DRTech98/RGB-Initials-Sign/DR_SIGN_REDO__Assembly.pdf

A

A

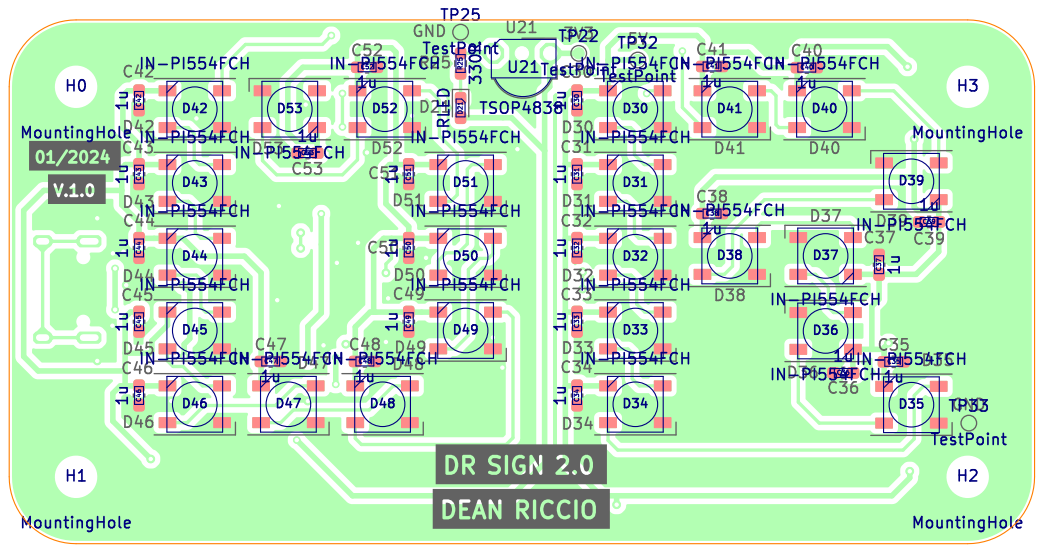
[picture p1: page 1]

Id: 1/1 Title: DR SIGN REDO

R20 C25 | C27 | C13 Y20 C22 R31 Q30 1 | 2 | 3 | 4 | 5 1 | 2 | 3 | 4 | 5 ABCD | ABCD Date: 2024-01-03 KiCad | E.D.A. | kicad | (7.0.0) Size: USLetter | Rev: 0.0

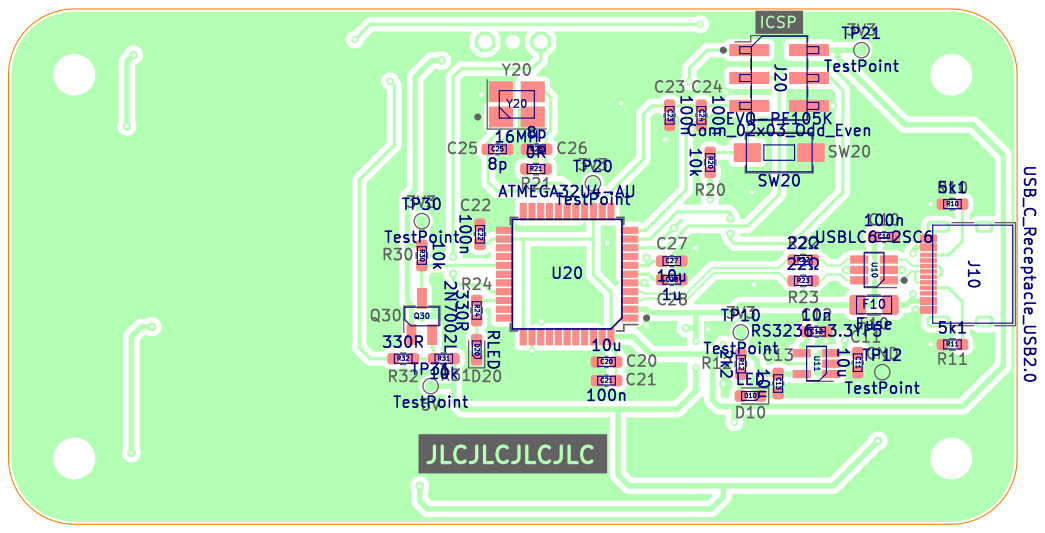
[picture p2: page 2]

Id: 1/1 Title: DR SIGN REDO
