DRTech98/RGB-Initials-Sign/DR_SIGN_REDO.pdf

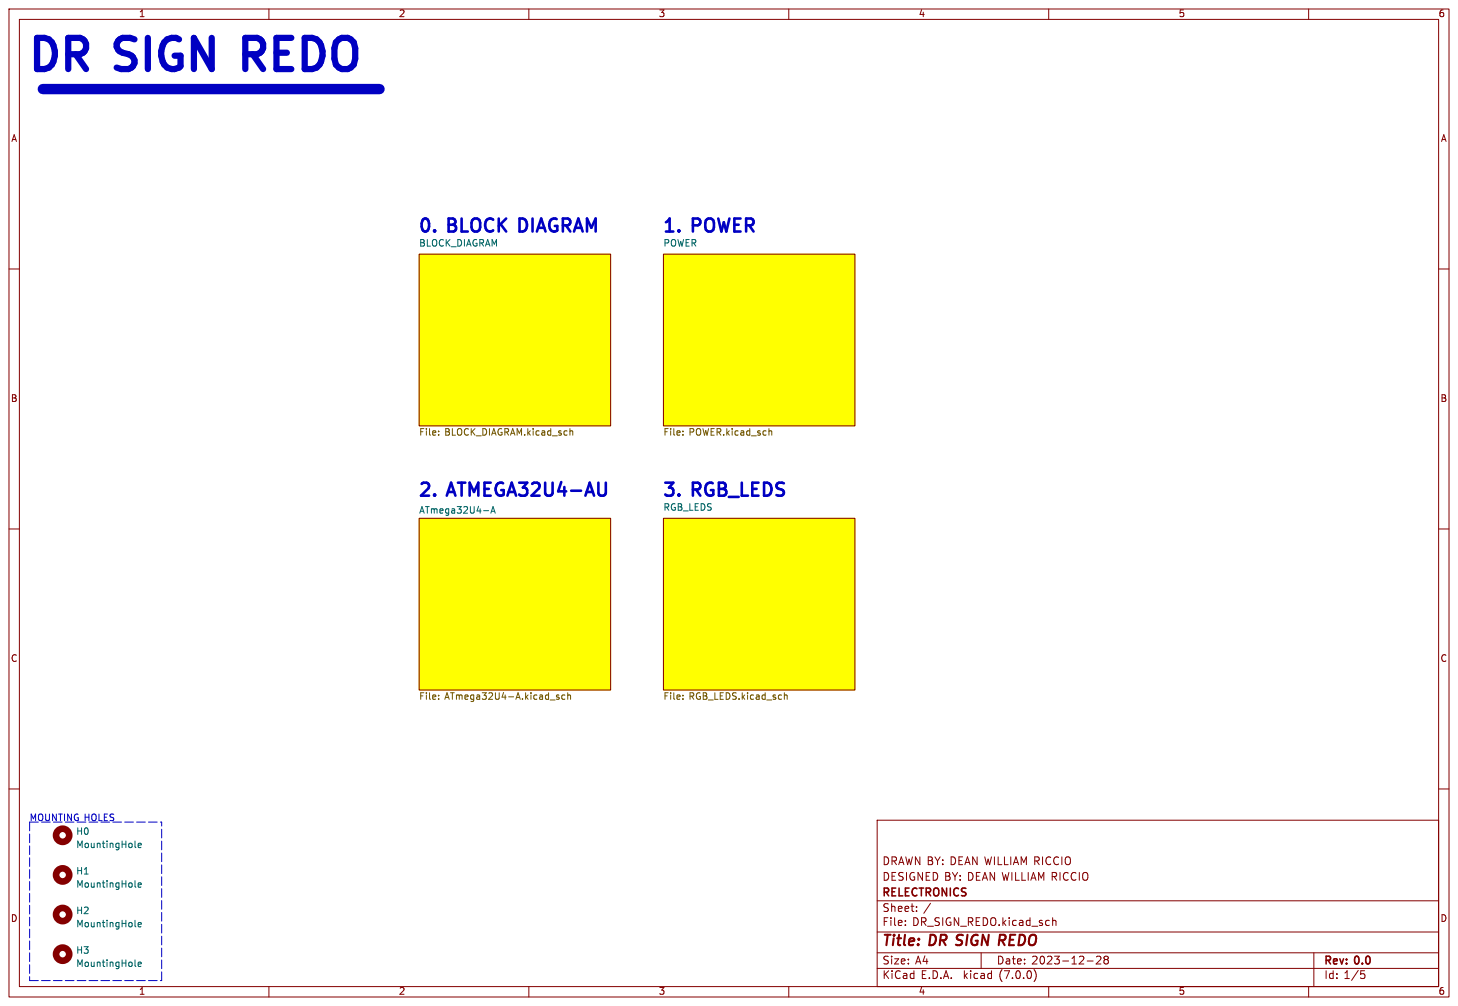
[picture p3: page 1]

File: ATmega32U4-A.kicad_sch H3 MountingHole H2 MountingHole H1 MountingHole H0 MountingHole

Id: 1/5 Title: DR SIGN REDO

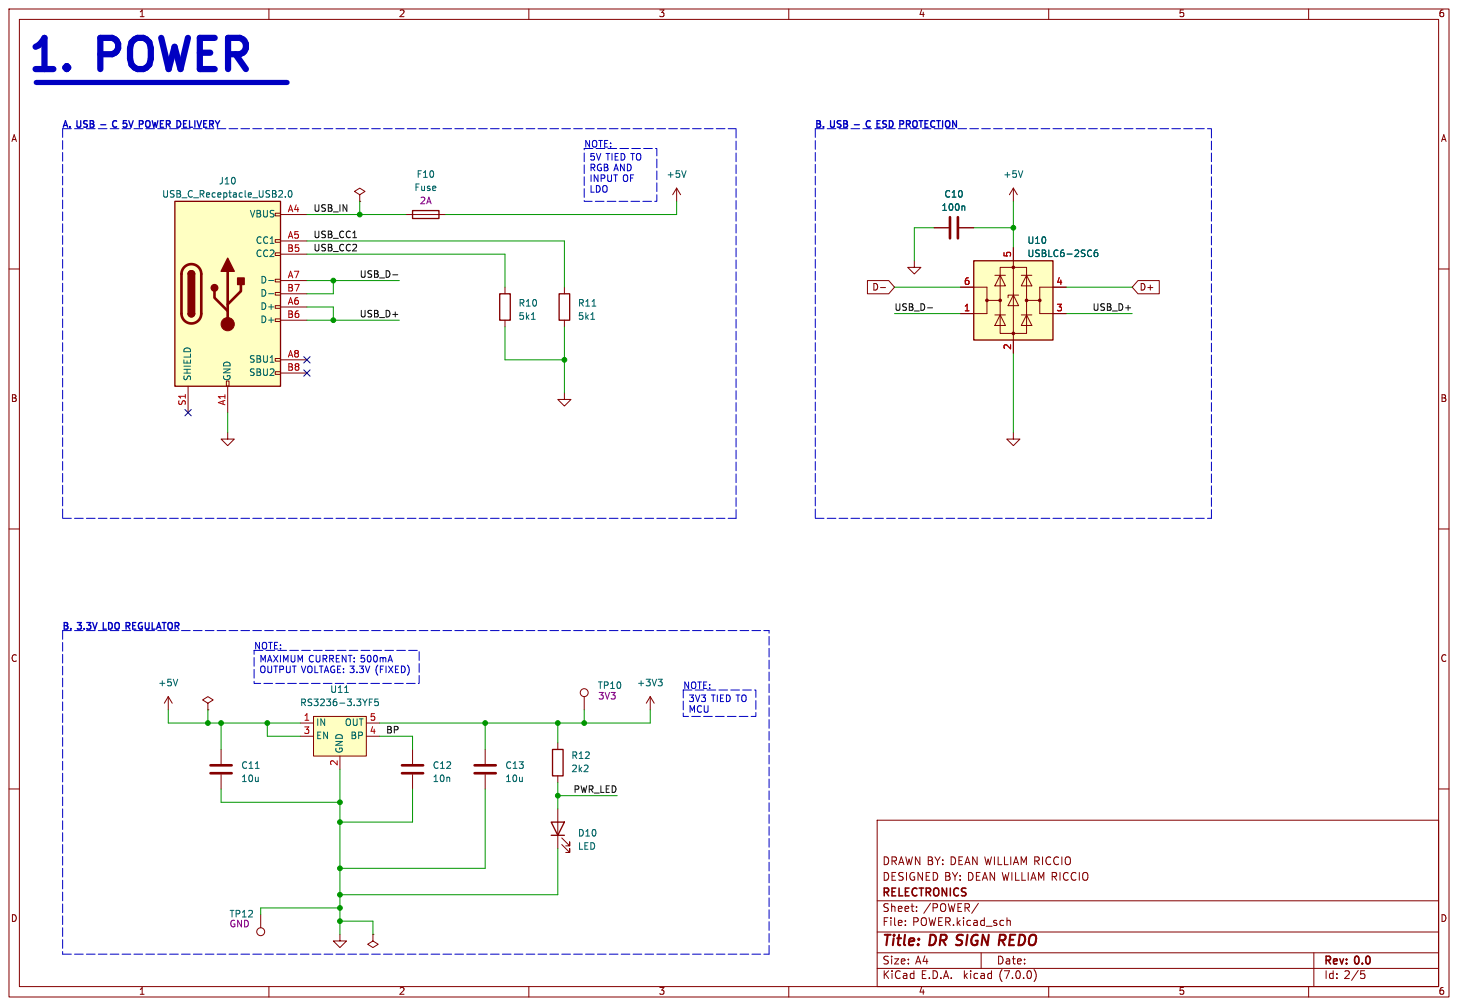
[picture p4: page 2]

A. USB - C 5V POWER DELIVERY B. 3.3V LDO REGULATOR

2 EN 3 BP 4 OUT 5 U11 RS3236-3.3YF5 TP12 GND

Id: 2/5 Title: DR SIGN REDO

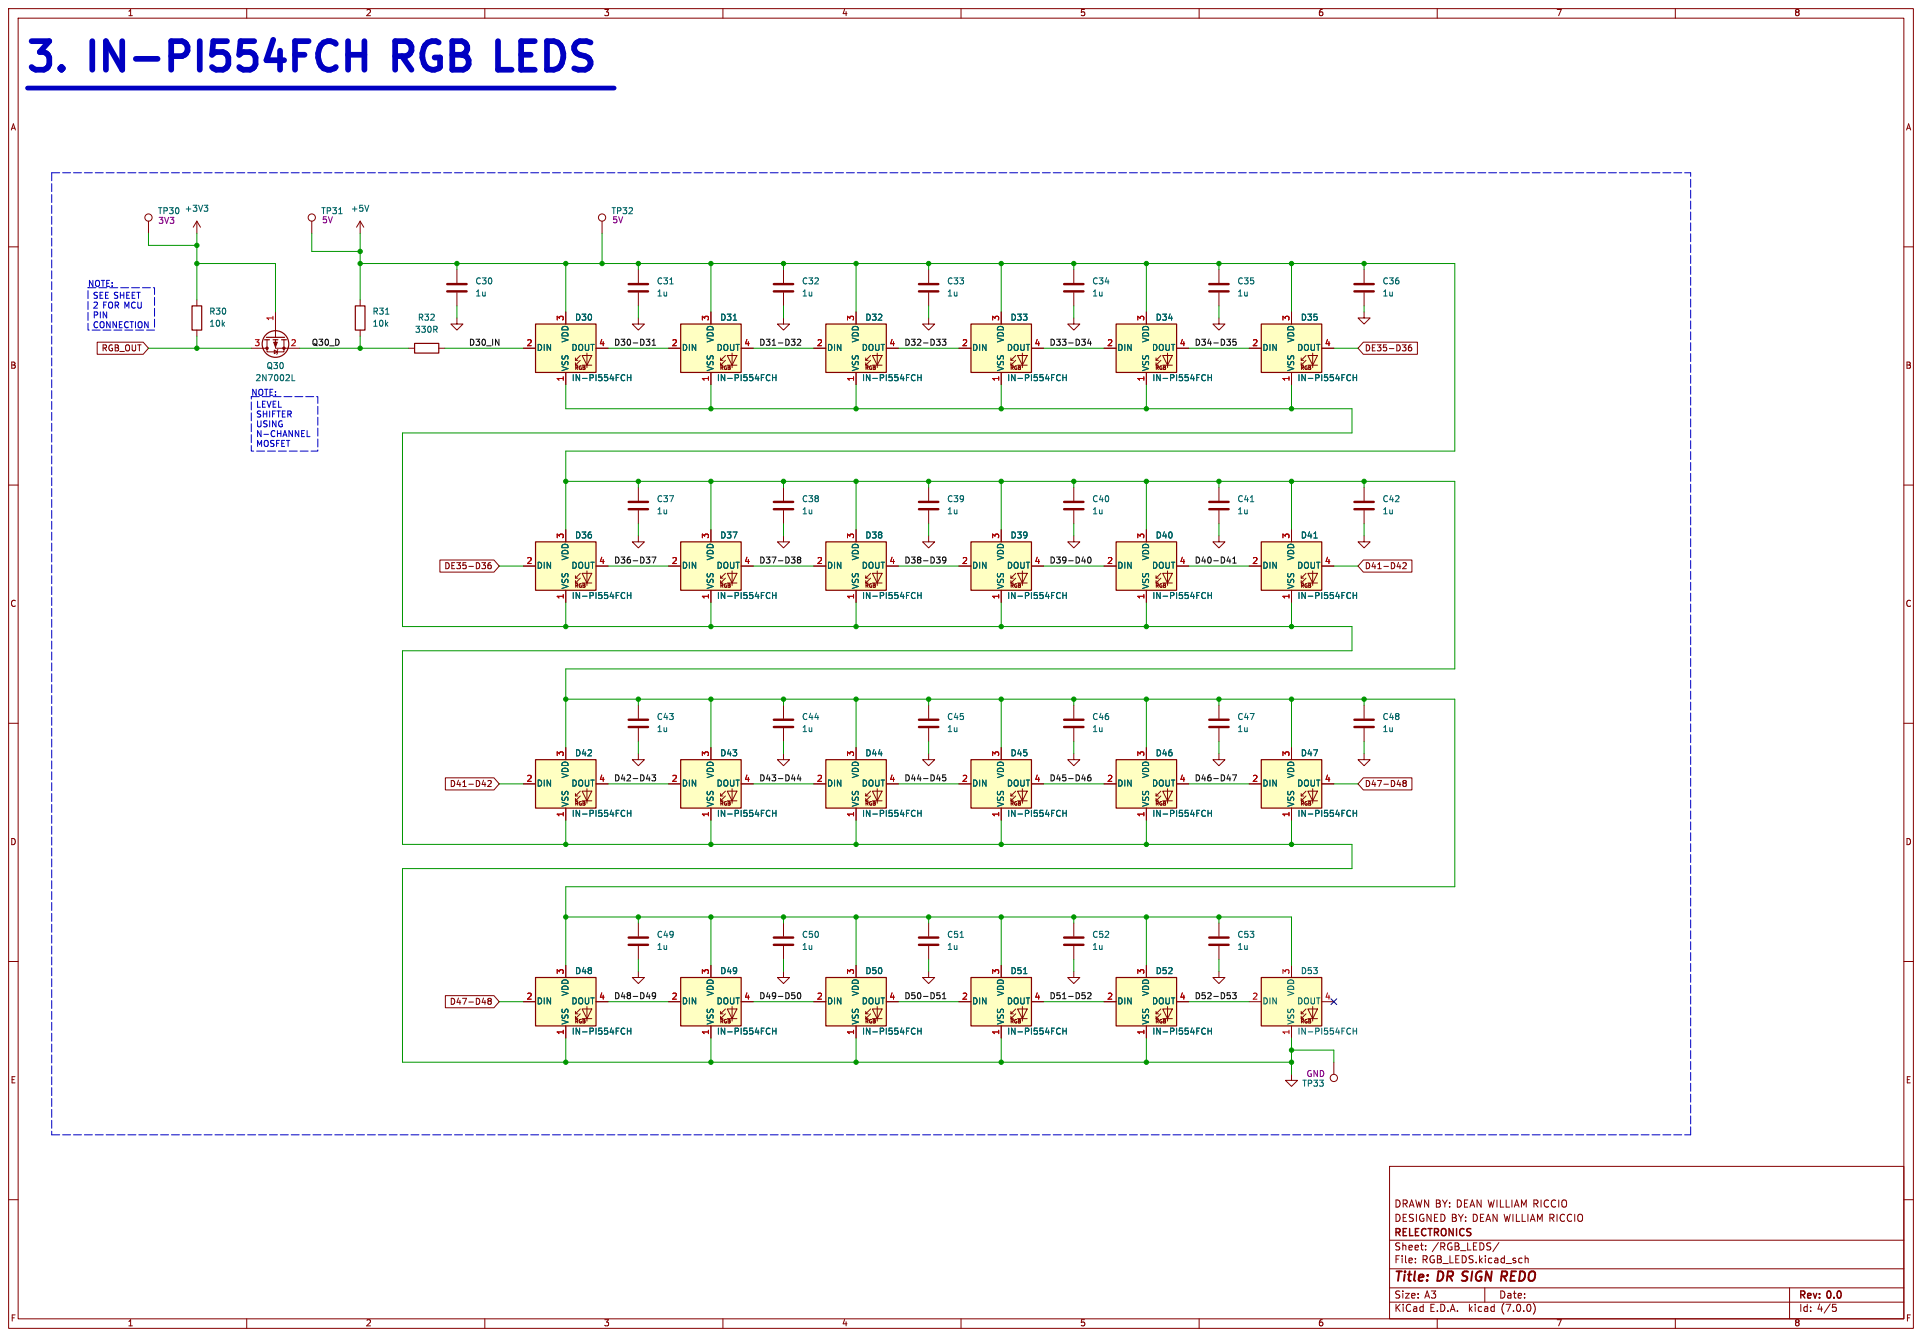
[picture p5: page 3]

N-CHANNEL MOSFET SEE SHEET
2 FOR MCU
PIN
CONNECTION

Id: 4/5 Title: DR SIGN REDO

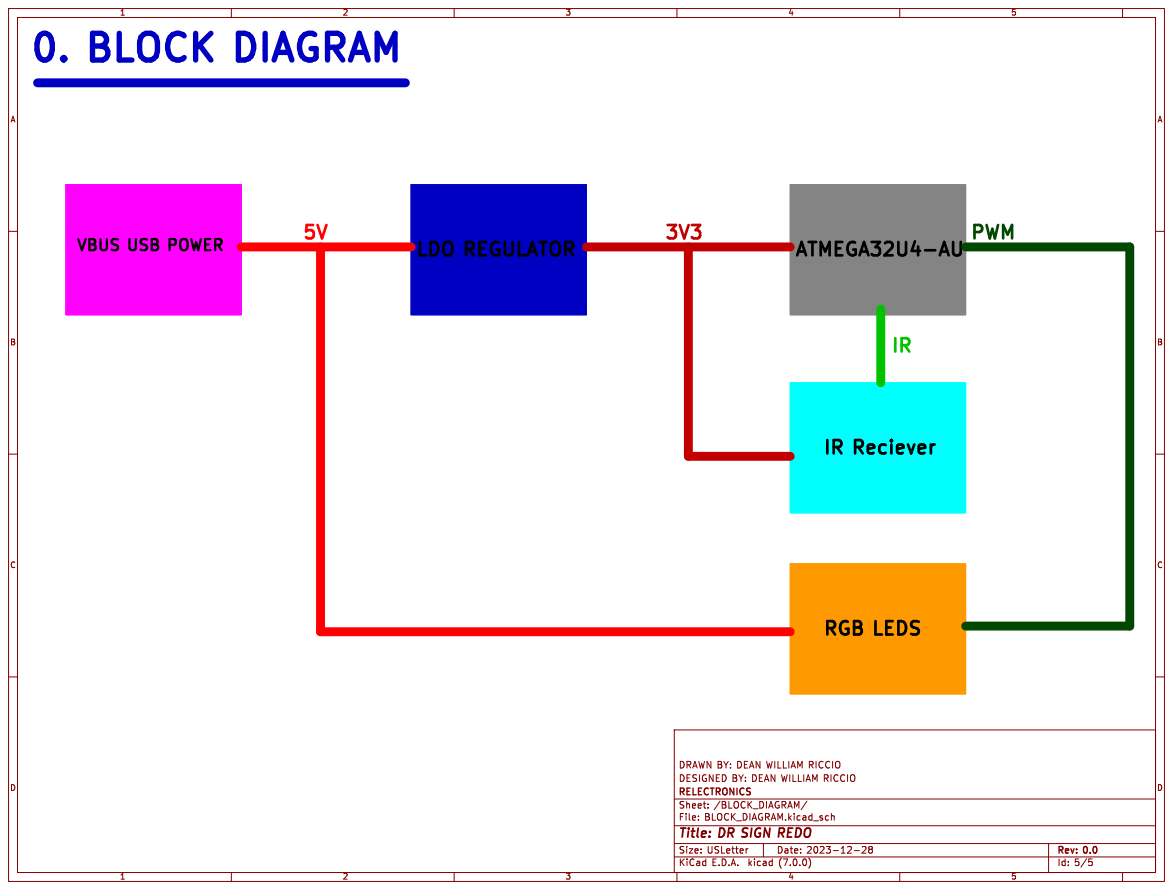
[picture p6: page 4]

Id: 5/5 Title: DR SIGN REDO

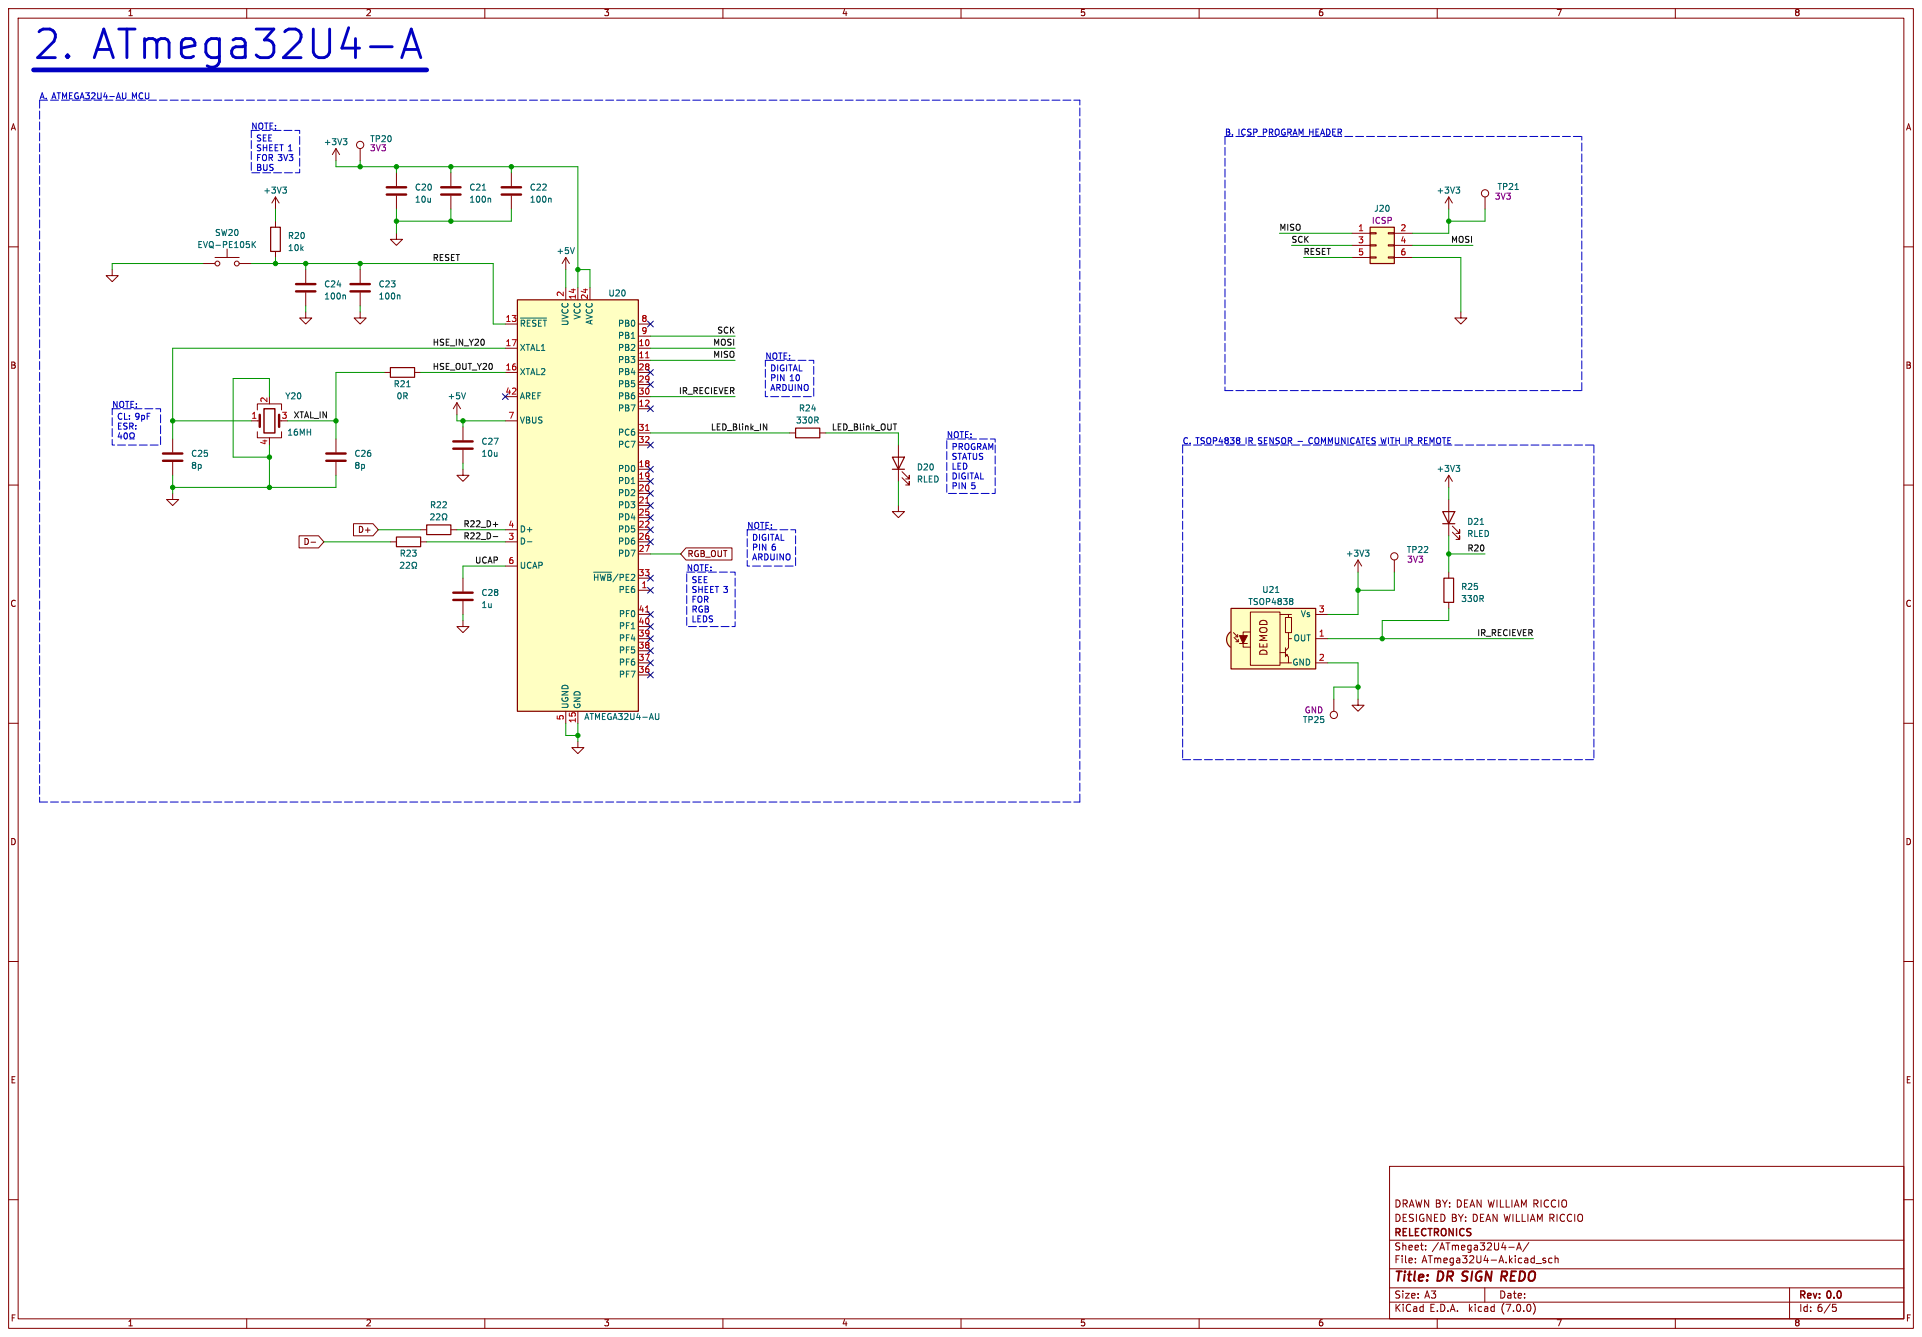
[picture p7: page 5]

Id: 6/5 Title: DR SIGN REDO
