DRTech98/RGB-Initials-Sign/(commit log)

2024-01-07 RGB Code used to control the IN-PI554FCH LEDs
2024-01-07 Original Zip file of the project made in 2022
    See the readme file to see the list of problems that this PCB had and why the project did not work as intended.
2024-01-13 PDF Version of Schematic
    Schematic includes block diagram, power, MCU, and RGB LED with logic level shifter to get rid of flickering.
2024-01-13 Zip File
    Zip file of the entire project. Includes schematic, PCB layout, BOM, CPL files, along with components folder with several custom symbols and footprints.
2024-01-15 Assembly File Of PCB - Front/Back
